AWenzel83/MCT-Labor_5529/README.md

# MCT-Labor_5529
Laboraufbau mit MSP-EXP430f5529-LP
