AWenzel83/MCT-Labor_5529/TODO.txt

-Battery-Protection einfuegen oder Halter für Akkus mit Schutzschaltung
