AWenzel83/MCT-Labor_5529/release/MCT_Labor_5529.pdf

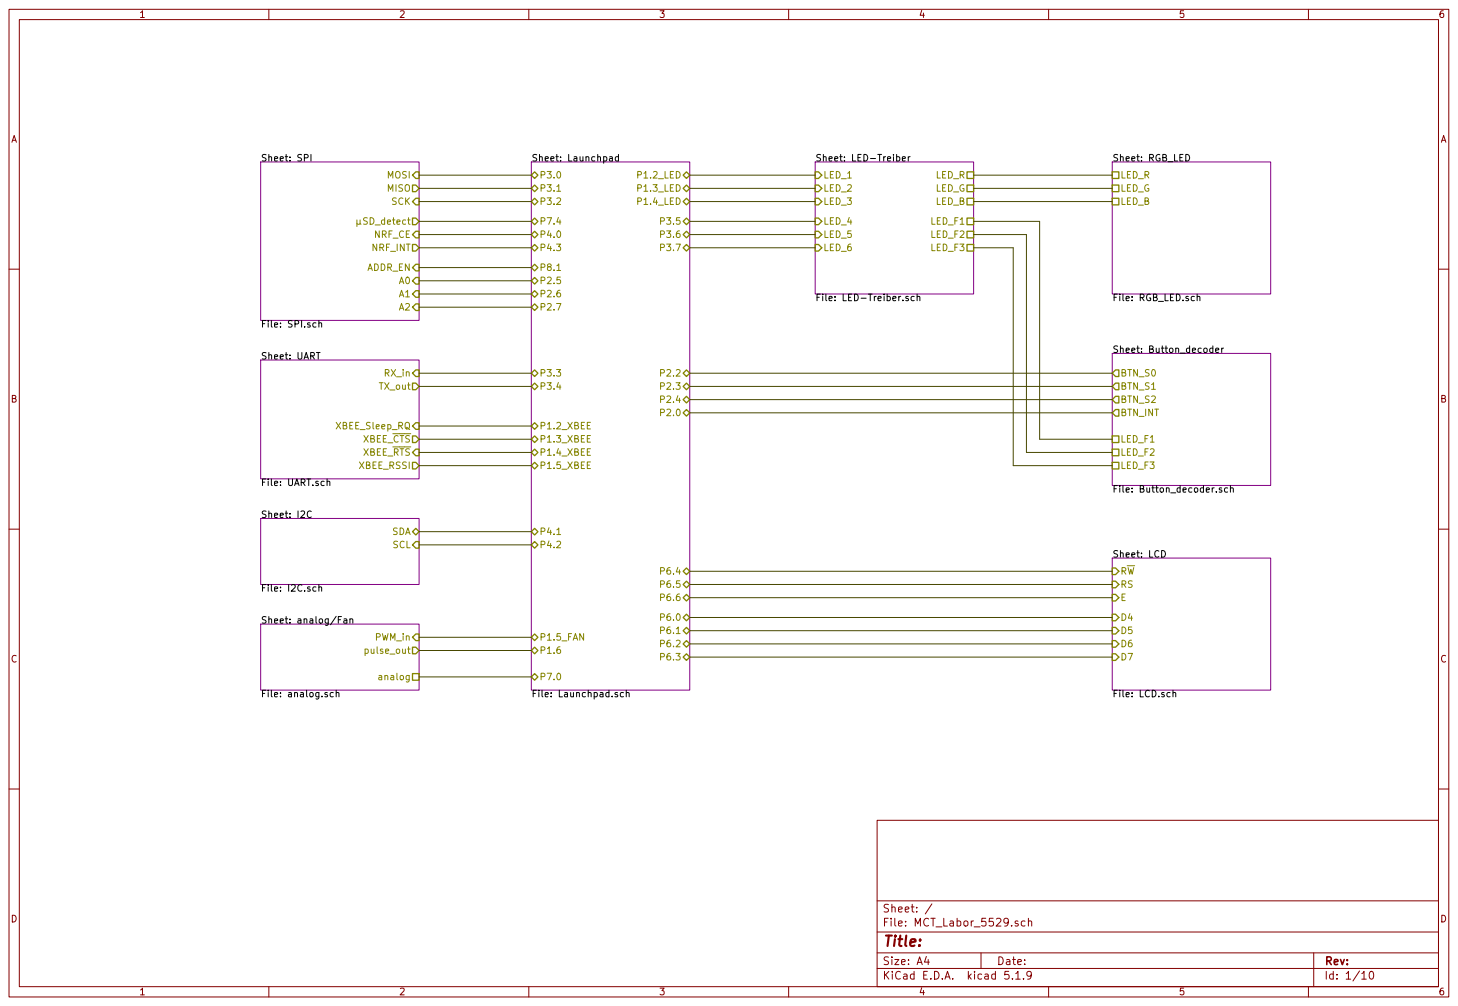
[picture p1: page 1]

File: LCD.sch D4 D5 D6 D7 RSRW

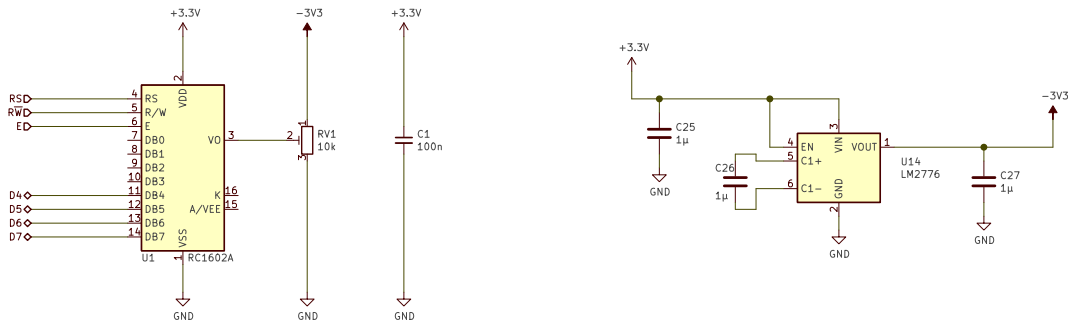
[picture p2: page 2]

Id: 2/10 Title: File: LCD.sch Sheet: /LCD/

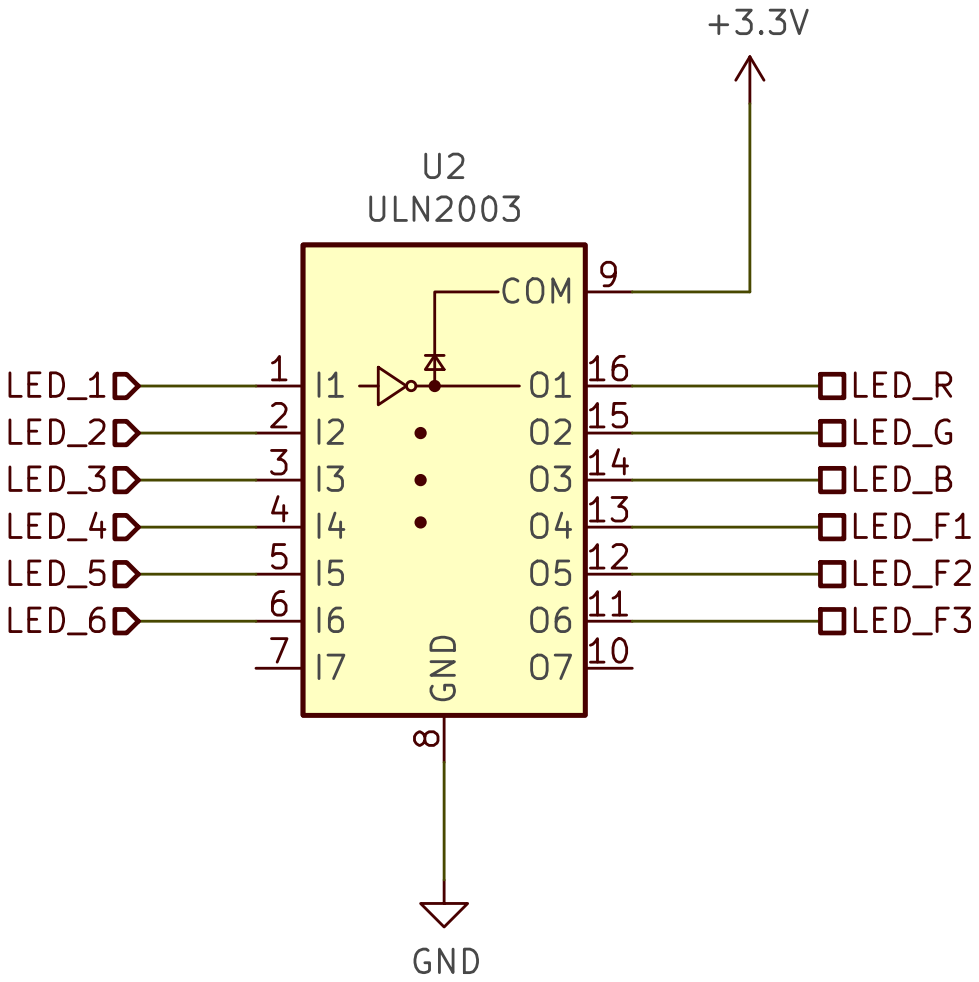
[picture p3: page 3]

Id: 3/10 Title: File: LED-Treiber.sch Sheet: /LED-Treiber/ GND

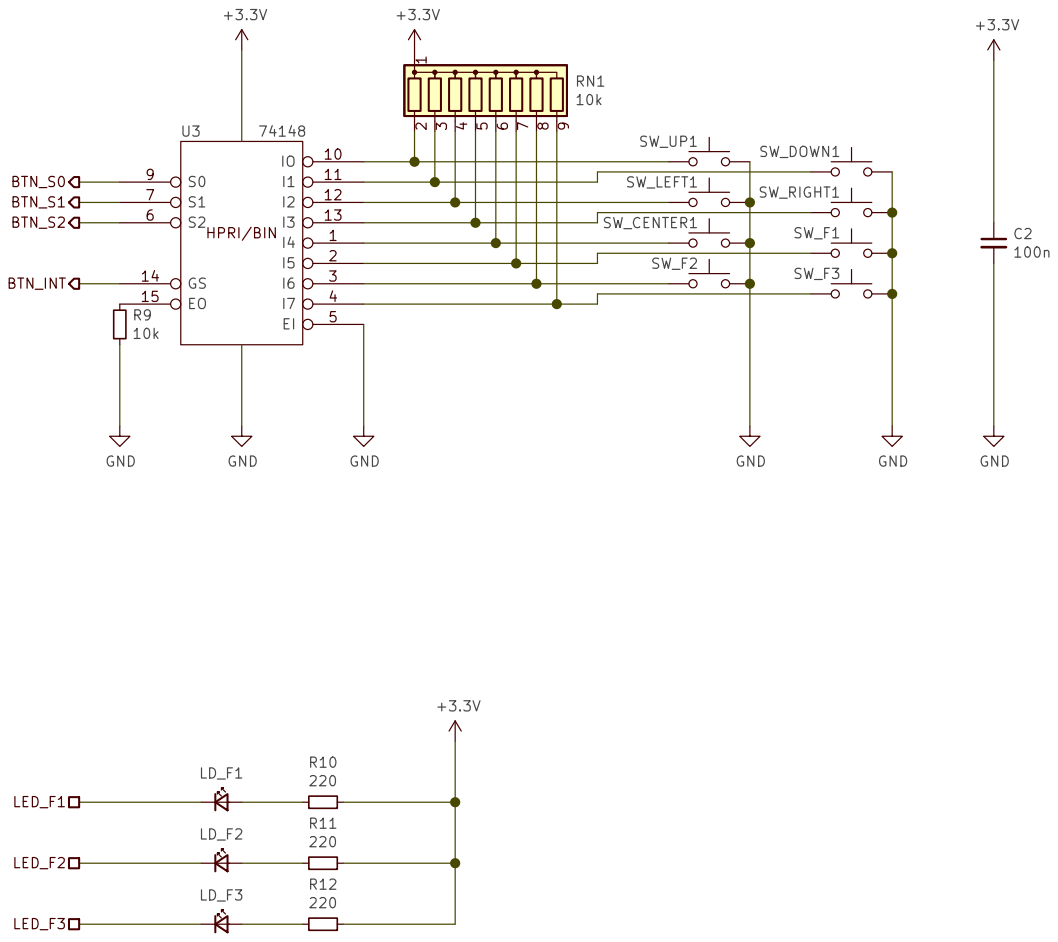
[picture p4: page 4]

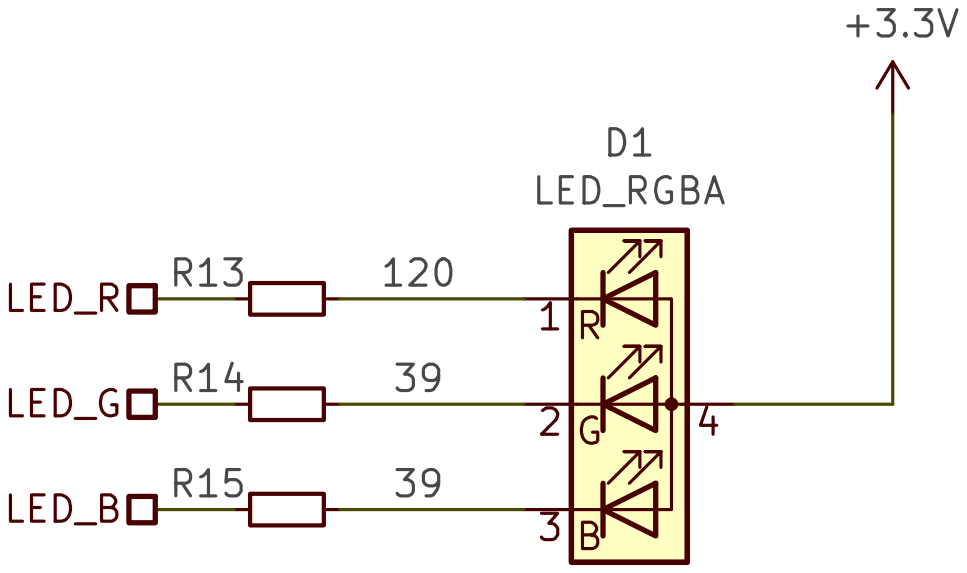
[picture p5: page 5]

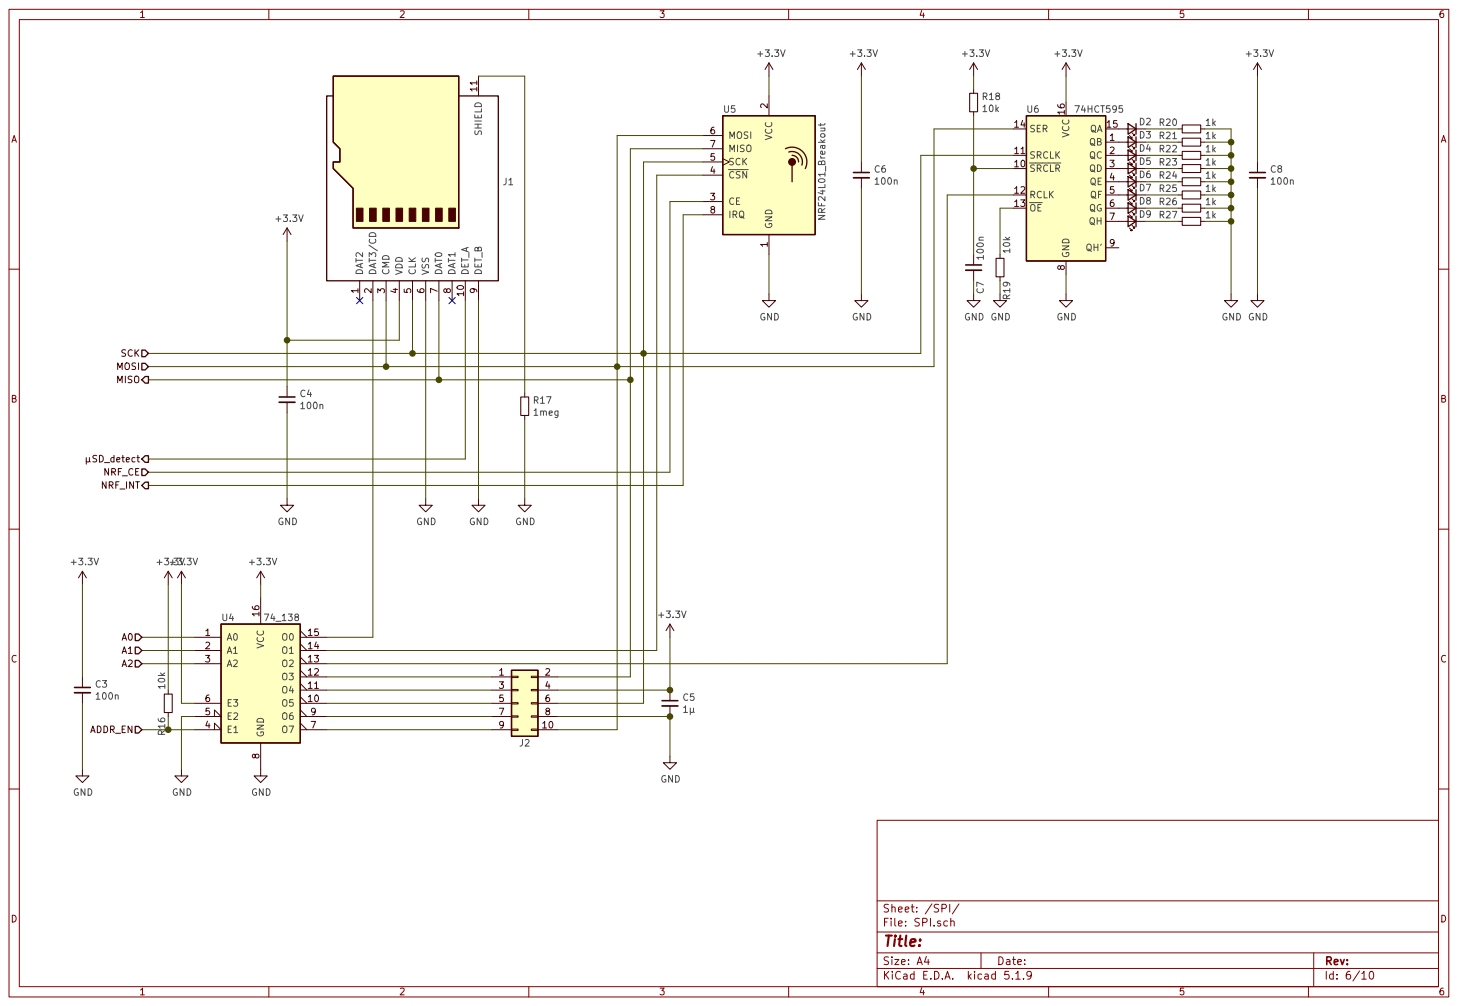
[picture p6: page 6]

2 CE 3 CSN 4 SCK 5 MOSI 6 MISO 7

Id: 6/10 Title: File: SPI.sch Sheet: /SPI/ DAT2

9 | 10

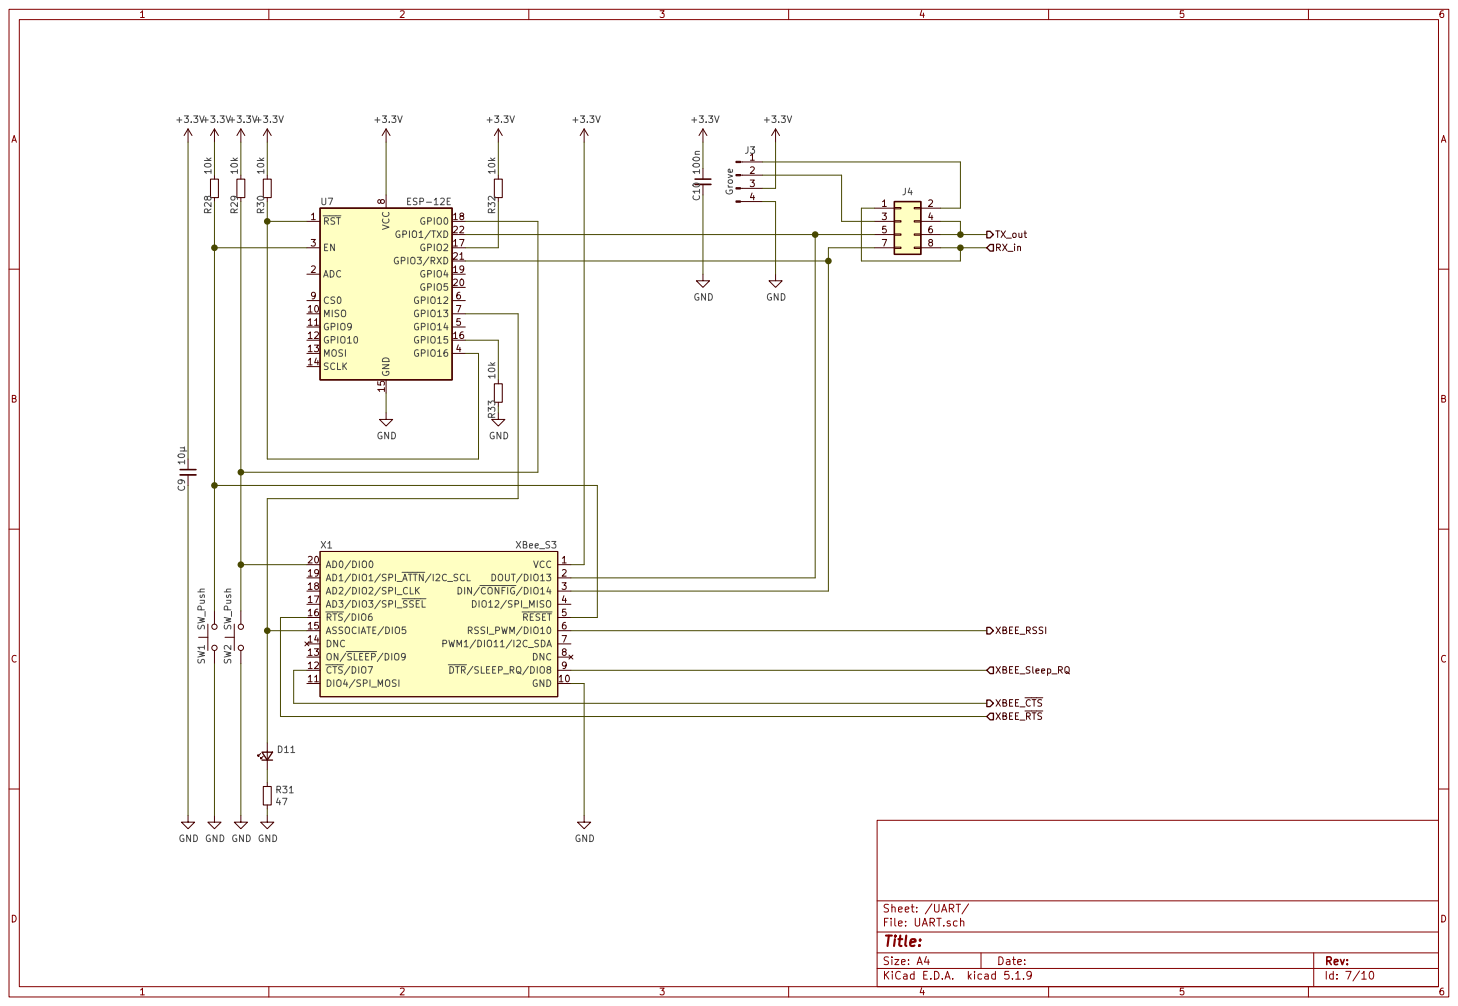
[picture p7: page 7]

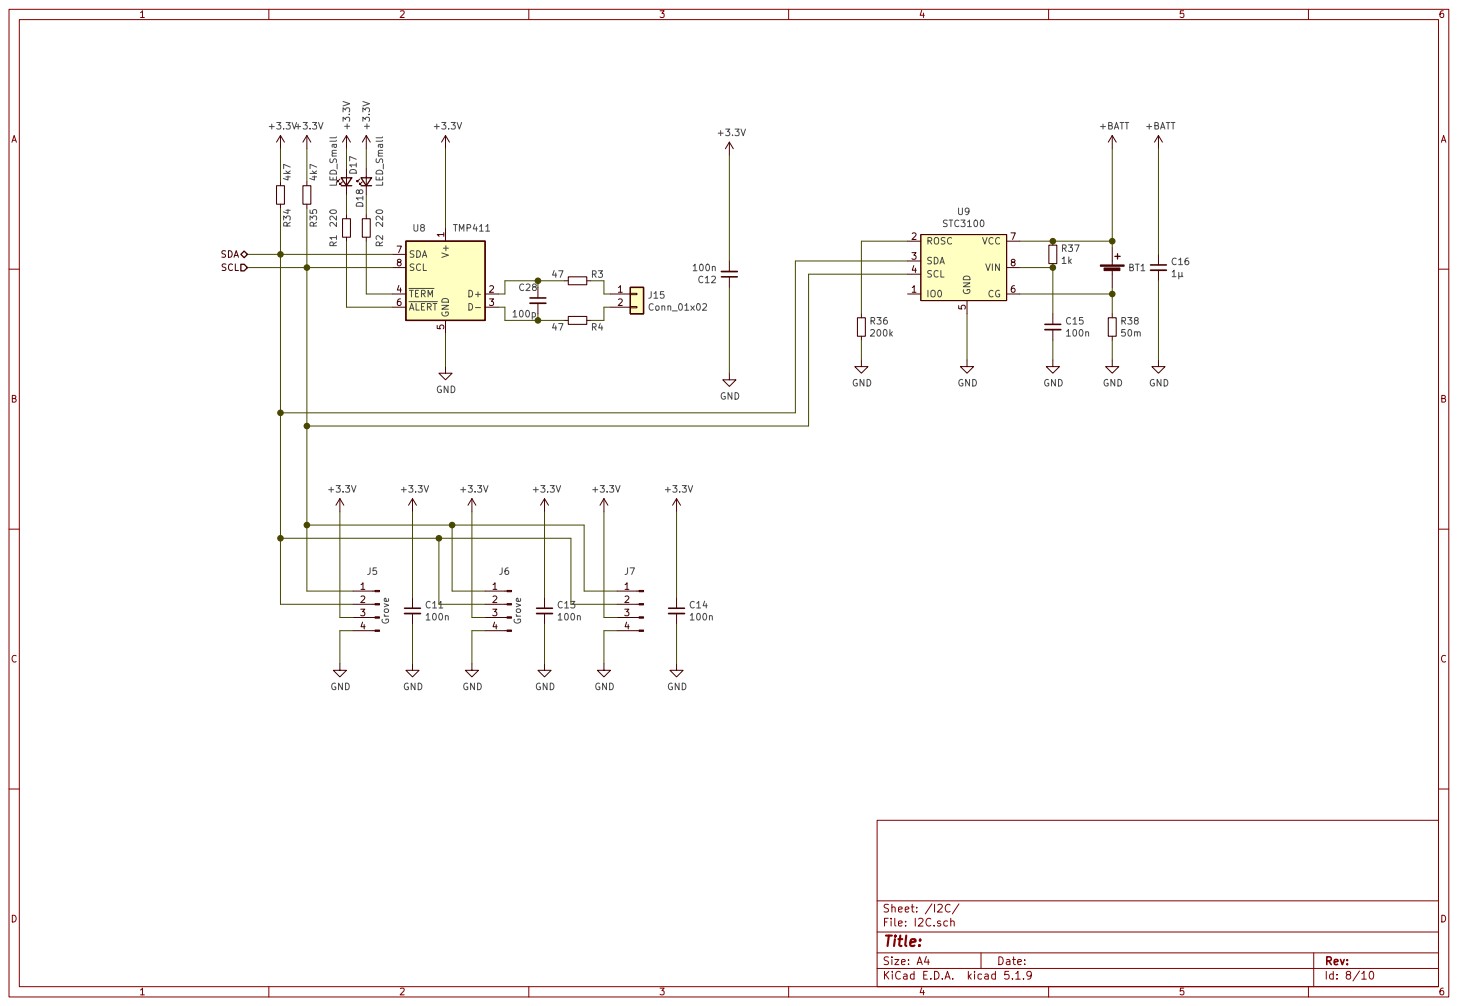
[picture p8: page 8]

5 ALERT 6 SDA 7 SCL 8 U8 TMP411 +3.3V GND

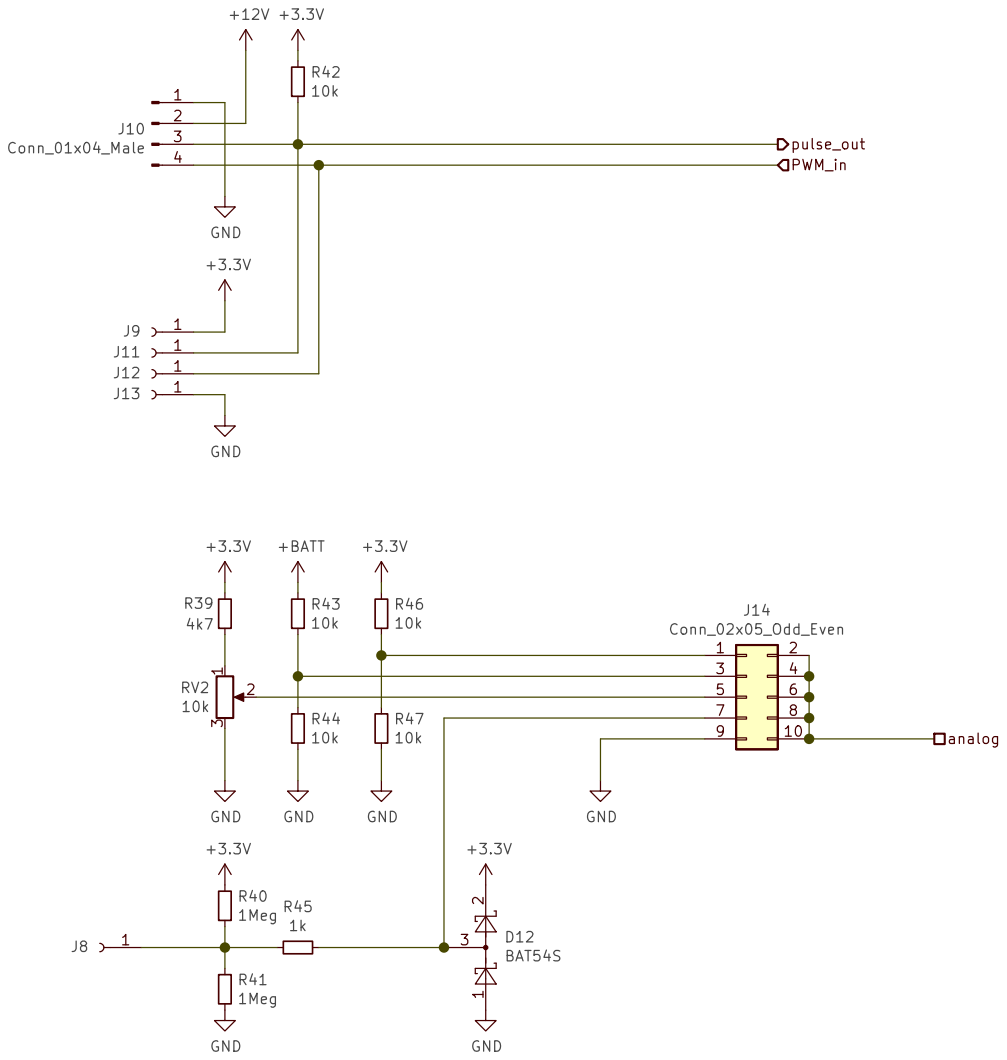
[picture p9: page 9]

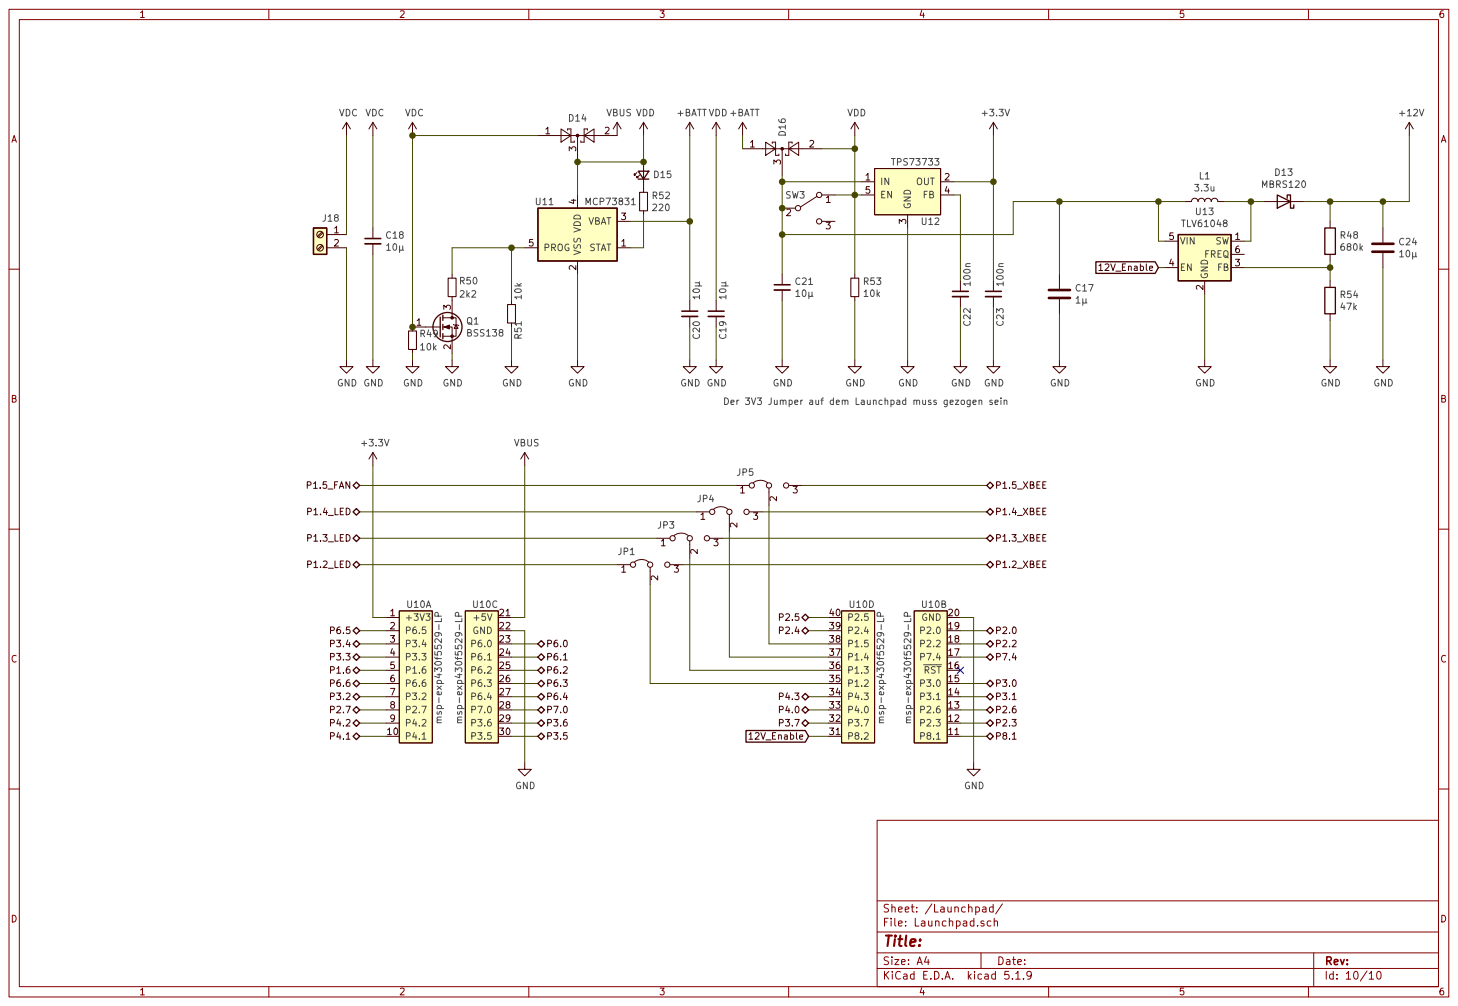
[picture p10: page 10]

2 FB 3 EN 4 VIN 5 FREQ 6 U13 TLV61048 +12V GND GND GND GND

3 FB 4 EN 5 U12 TPS73733 R51 10k GND GND

12V_Enable Der 3V3 Jumper auf dem Launchpad muss gezogen sein
