AWenzel83/MCT-Labor_5529/MCT_Labor_5529.kicad_pcb

## KiCad design MCT_Labor_5529.kicad_pcb (2021-04-28)

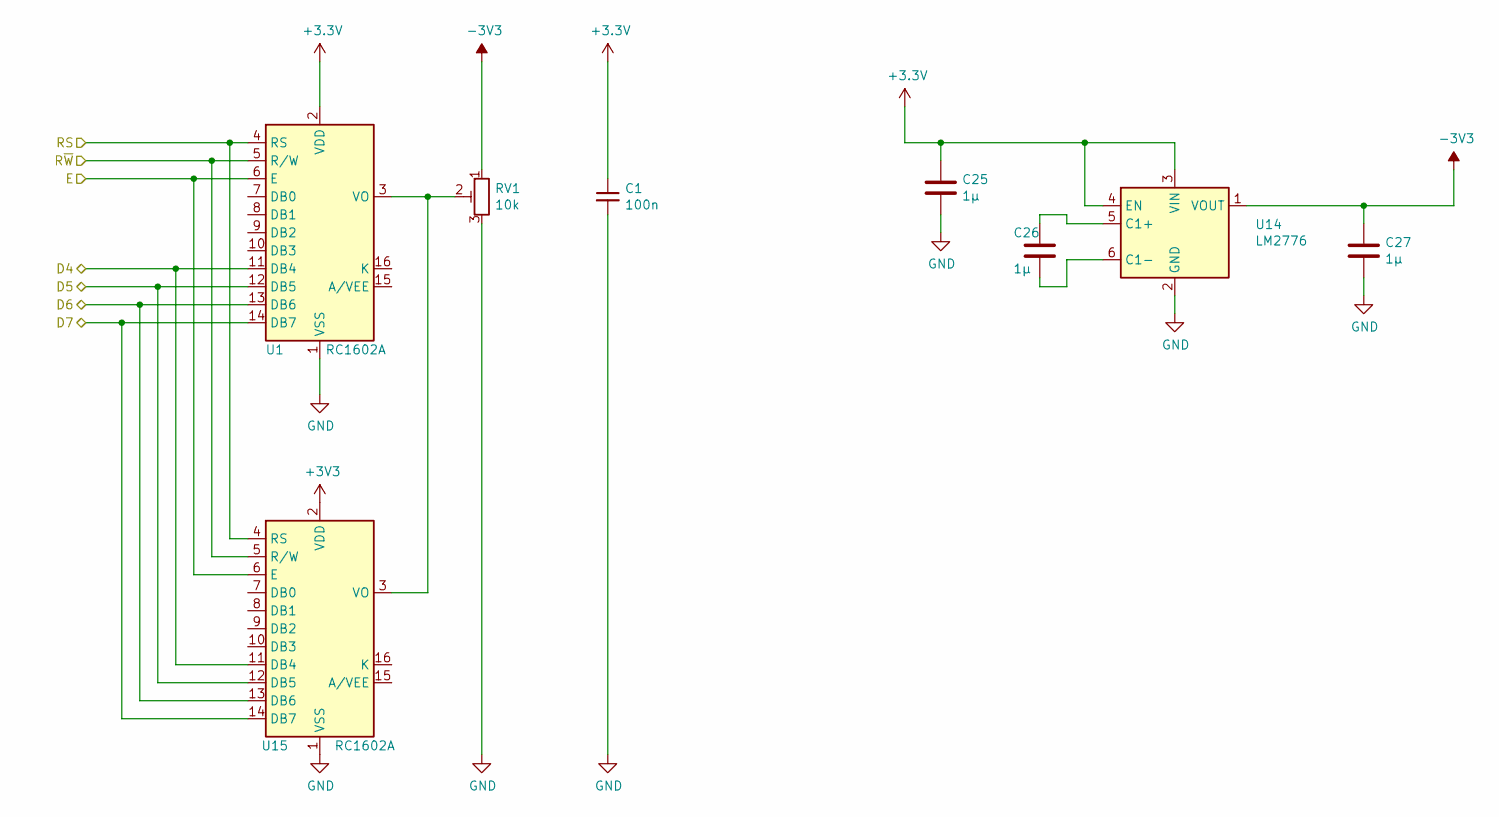
[picture p11: schematic LCD.sch]

Parts:
C1: 100n; C_0603_1608Metric_Pad1.05x0.95mm_HandSolder
C25, C26, C27: 1µ; C_0603_1608Metric_Pad1.05x0.95mm_HandSolder
RV1: 10k; Potentiometer_Bourns_3296P_Horizontal
U1: RC1602A; WC1602A
U14: LM2776; SOT-23-6
U15: RC1602A

Connections:
-3V3: C27.1, RV1.1, U14.1 (VOUT)
/LCD/D4: U1.11 (DB4), U15.11 (DB4); also elsewhere on the board
/LCD/D5: U1.12 (DB5), U15.12 (DB5); also elsewhere on the board
/LCD/D6: U1.13 (DB6), U15.13 (DB6); also elsewhere on the board
/LCD/D7: U1.14 (DB7), U15.14 (DB7); also elsewhere on the board
/LCD/E: U1.6 (E), U15.6 (E); also elsewhere on the board
/Launchpad/P6.4: U1.5 (R/W), U15.5 (R/W); also elsewhere on the board
/Launchpad/P6.5: U1.4 (RS), U15.4 (RS); also elsewhere on the board
GND: C1.2, C25.2, C27.2, RV1.3, U1.1 (VSS), U14.2 (GND), U15.1 (VSS); also elsewhere on the board
unnamed: C26.1, U14.5 (C1+)
unnamed: C26.2, U14.6 (C1-)
unnamed: RV1.2, U1.3 (VO), U15.3 (VO)

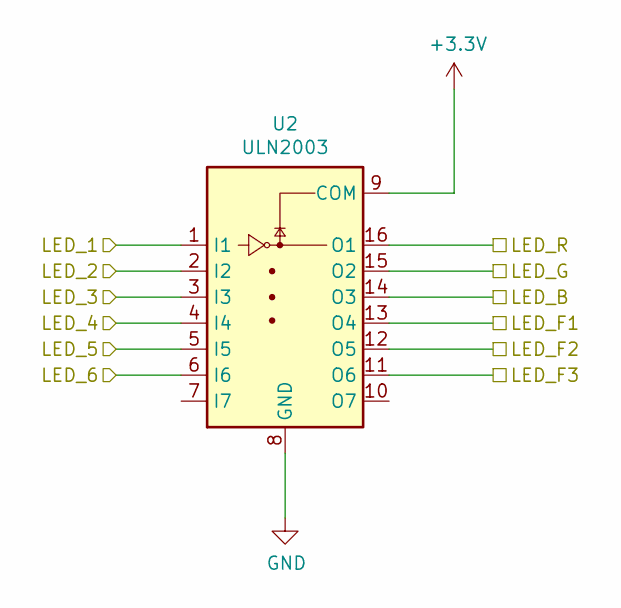
[picture p12: schematic LED-Treiber.sch]

Parts:
U2: ULN2003; SOIC-16_3.9x9.9mm_P1.27mm

Connections:
/Button_decoder/LED_F1: U2.13 (O4); also elsewhere on the board
/Button_decoder/LED_F2: U2.12 (O5); also elsewhere on the board
/Button_decoder/LED_F3: U2.11 (O6); also elsewhere on the board
/LED-Treiber/LED_1: U2.1 (I1); also elsewhere on the board
/LED-Treiber/LED_2: U2.2 (I2); also elsewhere on the board
/LED-Treiber/LED_3: U2.3 (I3); also elsewhere on the board
/LED-Treiber/LED_4: U2.4 (I4); also elsewhere on the board
/LED-Treiber/LED_5: U2.5 (I5); also elsewhere on the board
/LED-Treiber/LED_6: U2.6 (I6); also elsewhere on the board
/LED-Treiber/LED_B: U2.14 (O3); also elsewhere on the board
/LED-Treiber/LED_G: U2.15 (O2); also elsewhere on the board
/LED-Treiber/LED_R: U2.16 (O1); also elsewhere on the board
GND: U2.8 (GND); also elsewhere on the board

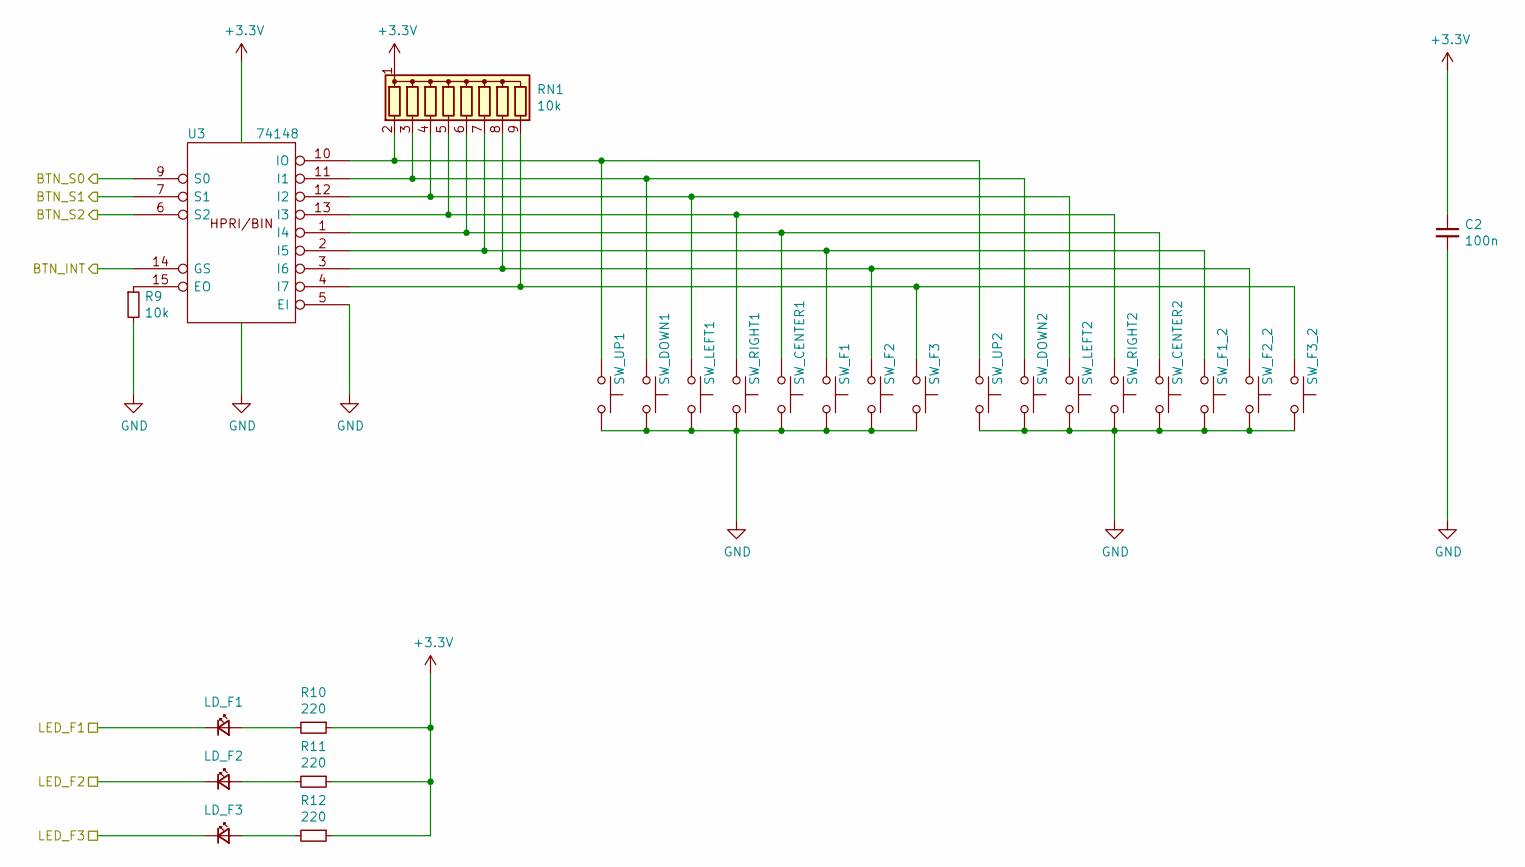
[picture p13: schematic Button_decoder.sch]

Parts:
C2: 100n; C_0603_1608Metric_Pad1.05x0.95mm_HandSolder
LD_F1, LD_F2, LD_F3: LED_Small; LED_D3.0mm
R9: 10k; R_0603_1608Metric_Pad1.05x0.95mm_HandSolder
R10, R11, R12: 220; R_0603_1608Metric_Pad1.05x0.95mm_HandSolder
RN1: 10k; R_Array_SIP9
SW_CENTER1: SW_MEC_5G; SW_MEC_5GSH9
SW_CENTER2: SW_MEC_5G; SW_SPST_Omron_B3FS-100xP
SW_DOWN1: SW_MEC_5G; SW_MEC_5GSH9
SW_DOWN2: SW_MEC_5G; SW_SPST_Omron_B3FS-100xP
SW_F1, SW_F2, SW_F3: SW_MEC_5G; SW_MEC_5GSH9
SW_F1_2: SW_MEC_5; SW_SPST_Omron_B3FS-100xP
SW_F2_2, SW_F3_2: SW_MEC_5G; SW_SPST_Omron_B3FS-100xP
SW_LEFT1: SW_MEC_5G; SW_MEC_5GSH9
SW_LEFT2: SW_MEC_5G; SW_SPST_Omron_B3FS-100xP
SW_RIGHT1: SW_MEC_5G; SW_MEC_5GSH9
SW_RIGHT2: SW_MEC_5G; SW_SPST_Omron_B3FS-100xP
SW_UP1: SW_MEC_5G; SW_MEC_5GSH9
SW_UP2: SW_MEC_5G; SW_SPST_Omron_B3FS-100xP
U3: 74148; SOIC-16_3.9x9.9mm_P1.27mm

Connections:
/Button_decoder/BTN_INT: U3.14 (GS); also elsewhere on the board
/Button_decoder/BTN_S0: U3.9 (S0); also elsewhere on the board
/Button_decoder/BTN_S1: U3.7 (S1); also elsewhere on the board
/Button_decoder/BTN_S2: U3.6 (S2); also elsewhere on the board
/Button_decoder/LED_F1: LD_F1.1 (K); also elsewhere on the board
/Button_decoder/LED_F2: LD_F2.1 (K); also elsewhere on the board
/Button_decoder/LED_F3: LD_F3.1 (K); also elsewhere on the board
GND: C2.2, R9.2, SW_CENTER1.3 (B), SW_CENTER1.4 (B), SW_CENTER2.3 (B), SW_CENTER2.4 (B), SW_DOWN1.3 (B), SW_DOWN1.4 (B), SW_DOWN2.3 (B), SW_DOWN2.4 (B), SW_F1.3 (B), SW_F1.4 (B), SW_F1_2.3 (B), SW_F1_2.4 (B), SW_F2.3 (B), SW_F2.4 (B), SW_F2_2.3 (B), SW_F2_2.4 (B), SW_F3.3 (B), SW_F3.4 (B), SW_F3_2.3 (B), SW_F3_2.4 (B), SW_LEFT1.3 (B), SW_LEFT1.4 (B), SW_LEFT2.3 (B), SW_LEFT2.4 (B), SW_RIGHT1.3 (B), SW_RIGHT1.4 (B), SW_RIGHT2.3 (B), SW_RIGHT2.4 (B), SW_UP1.3 (B), SW_UP1.4 (B), SW_UP2.3 (B), SW_UP2.4 (B), U3.5 (EI), U3.8 (GND); also elsewhere on the board
unnamed: LD_F1.2 (A), R10.2
unnamed: LD_F2.2 (A), R11.2
unnamed: LD_F3.2 (A), R12.2
unnamed: R9.1, U3.15 (EO)
unnamed: RN1.2 (R1), SW_UP1.1 (A), SW_UP1.2 (A), SW_UP2.1 (A), SW_UP2.2 (A), U3.10 (IO)
unnamed: RN1.3 (R2), SW_DOWN1.1 (A), SW_DOWN1.2 (A), SW_DOWN2.1 (A), SW_DOWN2.2 (A), U3.11 (I1)
unnamed: RN1.4 (R3), SW_LEFT1.1 (A), SW_LEFT1.2 (A), SW_LEFT2.1 (A), SW_LEFT2.2 (A), U3.12 (I2)
unnamed: RN1.5 (R4), SW_RIGHT1.1 (A), SW_RIGHT1.2 (A), SW_RIGHT2.1 (A), SW_RIGHT2.2 (A), U3.13 (I3)
unnamed: RN1.6 (R5), SW_CENTER1.1 (A), SW_CENTER1.2 (A), SW_CENTER2.1 (A), SW_CENTER2.2 (A), U3.1 (I4)
unnamed: RN1.7 (R6), SW_F1.1 (A), SW_F1.2 (A), SW_F1_2.1 (A), SW_F1_2.2 (A), U3.2 (I5)
unnamed: RN1.8 (R7), SW_F2.1 (A), SW_F2.2 (A), SW_F2_2.1 (A), SW_F2_2.2 (A), U3.3 (I6)
unnamed: RN1.9 (R8), SW_F3.1 (A), SW_F3.2 (A), SW_F3_2.1 (A), SW_F3_2.2 (A), U3.4 (I7)

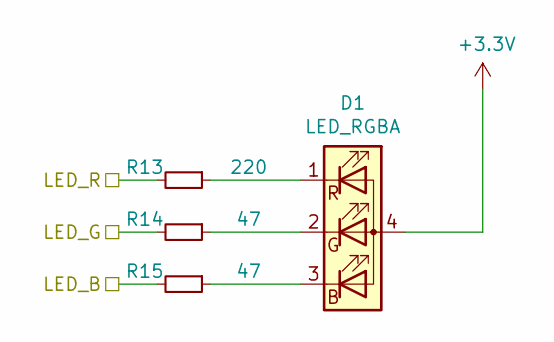
[picture p14: schematic RGB_LED.sch]

Parts:
D1: LED_RGBA; LED_Cree-PLCC4_3.2x2.8mm_CCW
R13: 220; R_0603_1608Metric_Pad1.05x0.95mm_HandSolder
R14, R15: 47; R_0603_1608Metric_Pad1.05x0.95mm_HandSolder

Connections:
/LED-Treiber/LED_B: R15.2; also elsewhere on the board
/LED-Treiber/LED_G: R14.2; also elsewhere on the board
/LED-Treiber/LED_R: R13.2; also elsewhere on the board
unnamed: D1.1 (RK), R13.1
unnamed: D1.2 (GK), R14.1
unnamed: D1.3 (BK), R15.1

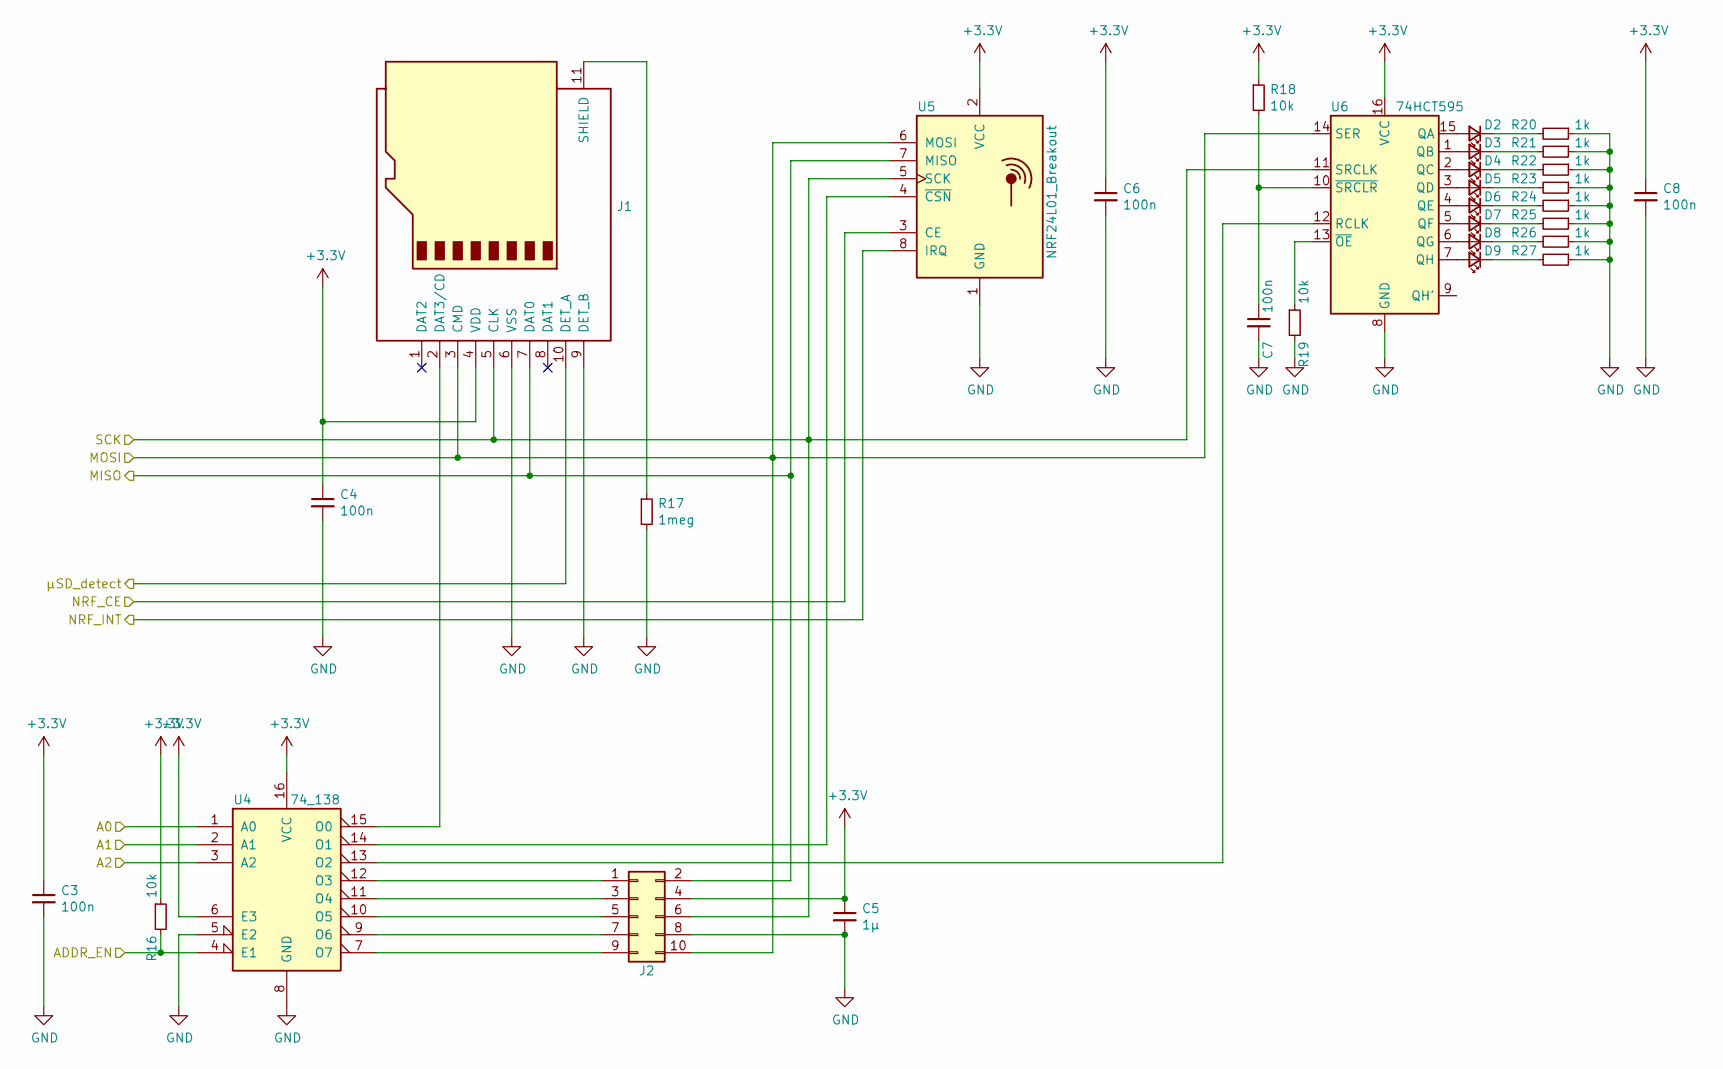
[picture p15: schematic SPI.sch]

Parts:
C3, C4, C6, C7, C8: 100n; C_0603_1608Metric_Pad1.05x0.95mm_HandSolder
C5: 1µ; C_0603_1608Metric_Pad1.05x0.95mm_HandSolder
D2, D3, D4, D5, D6, D7, D8, D9: LED_Small; LED_0603_1608Metric_Pad1.05x0.95mm_HandSolder
J1: Micro_SD_Card_Det; microSD_HC_Hirose_DM3D-SF
J2: Conn_02x05_Odd_Even; PinHeader_2x05_P2.54mm_Vertical
R16, R18, R19: 10k; R_0603_1608Metric_Pad1.05x0.95mm_HandSolder
R17: 1meg; R_0603_1608Metric_Pad1.05x0.95mm_HandSolder
R20, R21, R22, R23, R24, R25, R26, R27: 1k; R_0603_1608Metric_Pad1.05x0.95mm_HandSolder
U4: 74_138; SOIC-16_3.9x9.9mm_P1.27mm
U5: NRF24L01_Breakout; nRF24L01_Breakout
U6: 74HCT595; SOIC-16_3.9x9.9mm_P1.27mm

Connections:
/Launchpad/P3.2: J1.5 (CLK), J2.6, U5.5 (SCK), U6.11 (SRCLK); also elsewhere on the board
/Launchpad/P7.4: J1.10 (DET_A); also elsewhere on the board
/SPI/A0: U4.1 (A0); also elsewhere on the board
/SPI/A1: U4.2 (A1); also elsewhere on the board
/SPI/A2: U4.3 (A2); also elsewhere on the board
/SPI/ADDR_EN: R16.2, U4.4 (E1); also elsewhere on the board
/SPI/MISO: J1.7 (DAT0), J2.2, U5.7 (MISO); also elsewhere on the board
/SPI/MOSI: J1.3 (CMD), J2.10, U5.6 (MOSI), U6.14 (SER); also elsewhere on the board
/SPI/NRF_CE: U5.3 (CE); also elsewhere on the board
/SPI/NRF_INT: U5.8 (IRQ); also elsewhere on the board
GND: C3.2, C4.2, C5.2, C6.2, C7.2, C8.2, J1.6 (VSS), J1.9 (DET_B), J2.8, R17.2, R19.2, R20.1, R21.1, R22.1, R23.1, R24.1, R25.1, R26.1, R27.1, U4.5 (E2), U4.8 (GND), U5.1 (GND), U6.8 (GND); also elsewhere on the board
unnamed: C7.1, R18.2, U6.10 (~SRCLR)
unnamed: D2.1 (K), R20.2
unnamed: D2.2 (A), U6.15 (QA)
unnamed: D3.1 (K), R21.2
unnamed: D3.2 (A), U6.1 (QB)
unnamed: D4.1 (K), R22.2
unnamed: D4.2 (A), U6.2 (QC)
unnamed: D5.1 (K), R23.2
unnamed: D5.2 (A), U6.3 (QD)
unnamed: D6.1 (K), R24.2
unnamed: D6.2 (A), U6.4 (QE)
unnamed: D7.1 (K), R25.2
unnamed: D7.2 (A), U6.5 (QF)
unnamed: D8.1 (K), R26.2
unnamed: D8.2 (A), U6.6 (QG)
unnamed: D9.1 (K), R27.2
unnamed: D9.2 (A), U6.7 (QH)
unnamed: J1.2 (DAT3/CD), U4.15 (O0)
unnamed: J1.11 (SHIELD), R17.1
unnamed: J2.1, U4.12 (O3)
unnamed: J2.3, U4.11 (O4)
unnamed: J2.5, U4.10 (O5)
unnamed: J2.7, U4.9 (O6)
unnamed: J2.9, U4.7 (O7)
unnamed: R19.1, U6.13 (~OE)
unnamed: U4.13 (O2), U6.12 (RCLK)
unnamed: U4.14 (O1), U5.4 (~CSN)

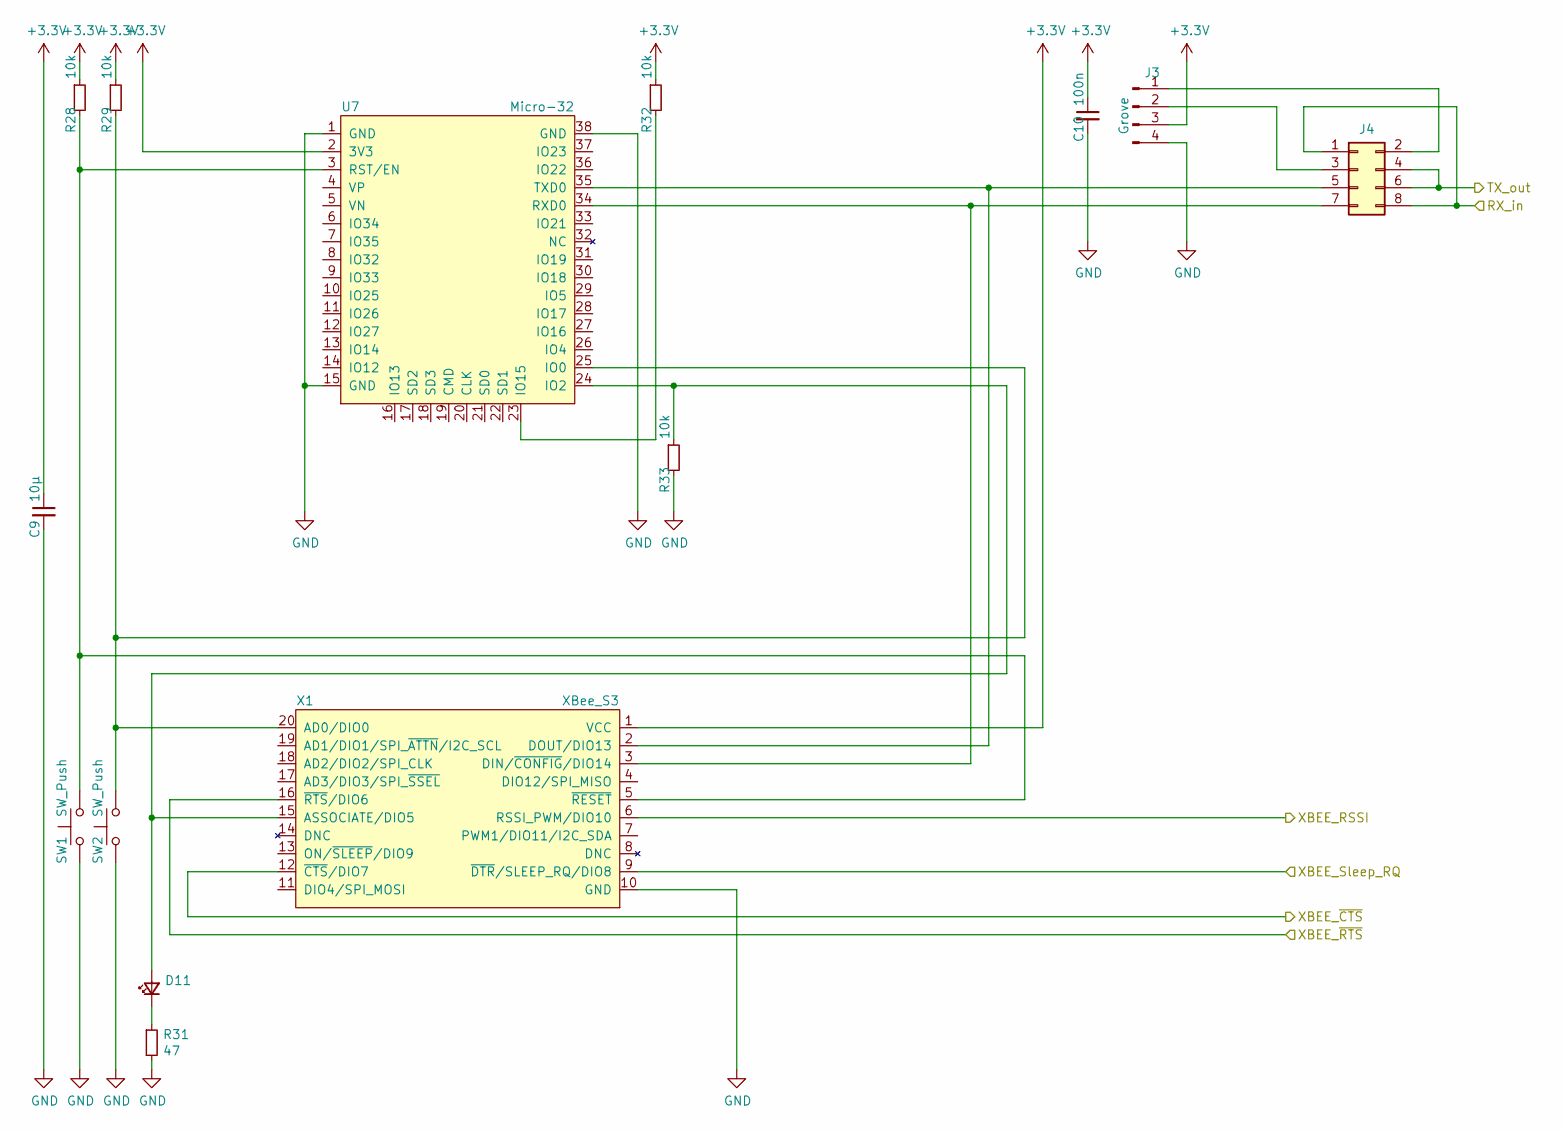
[picture p16: schematic UART.sch]

Parts:
C9: 10µ; C_1206_3216Metric_Pad1.42x1.75mm_HandSolder
C10: 100n; C_0603_1608Metric_Pad1.05x0.95mm_HandSolder
D11: LED_Small; LED_0603_1608Metric_Pad1.05x0.95mm_HandSolder
J3: Grove; NS-Tech_Grove_1x04_P2mm_Vertical
J4: Conn_02x04_Odd_Even; PinHeader_2x04_P2.54mm_Vertical
R28, R29, R32, R33: 10k; R_0603_1608Metric_Pad1.05x0.95mm_HandSolder
R31: 47; R_0603_1608Metric_Pad1.05x0.95mm_HandSolder
SW1, SW2: SW_Push; SW_Tactile_SPST_Angled_PTS645Vx39-2LFS
U7: Micro-32; micro32
X1: XBee_S3; XBEE_THT

Connections:
/Launchpad/P1.2_XBEE: X1.9 (~DTR~/SLEEP_RQ/DIO8); also elsewhere on the board
/Launchpad/P1.3_XBEE: X1.12 (~CTS~/DIO7); also elsewhere on the board
/Launchpad/P1.4_XBEE: X1.16 (~RTS~/DIO6); also elsewhere on the board
/Launchpad/P1.5_XBEE: X1.6 (RSSI_PWM/DIO10); also elsewhere on the board
/Launchpad/P3.3: J4.1, J4.8; also elsewhere on the board
/Launchpad/P3.4: J4.4, J4.6; also elsewhere on the board
GND: C9.2, C10.2, J3.4, R31.2, R33.2, SW1.1, SW2.1, U7.1 (GND), U7.15 (GND), U7.38 (GND), X1.10 (GND); also elsewhere on the board
unnamed: D11.1 (K), R31.1
unnamed: D11.2 (A), R33.1, U7.24 (IO2), X1.15 (ASSOCIATE/DIO5)
unnamed: J3.1, J4.2
unnamed: J3.2, J4.3
unnamed: J4.5, U7.35 (TXD0), X1.2 (DOUT/DIO13)
unnamed: J4.7, U7.34 (RXD0), X1.3 (DIN/~CONFIG~/DIO14)
unnamed: R28.2, SW1.2, U7.3 (RST/EN), X1.5 (~RESET)
unnamed: R29.2, SW2.2, U7.25 (IO0), X1.20 (AD0/DIO0)
unnamed: R32.2, U7.23 (IO15)

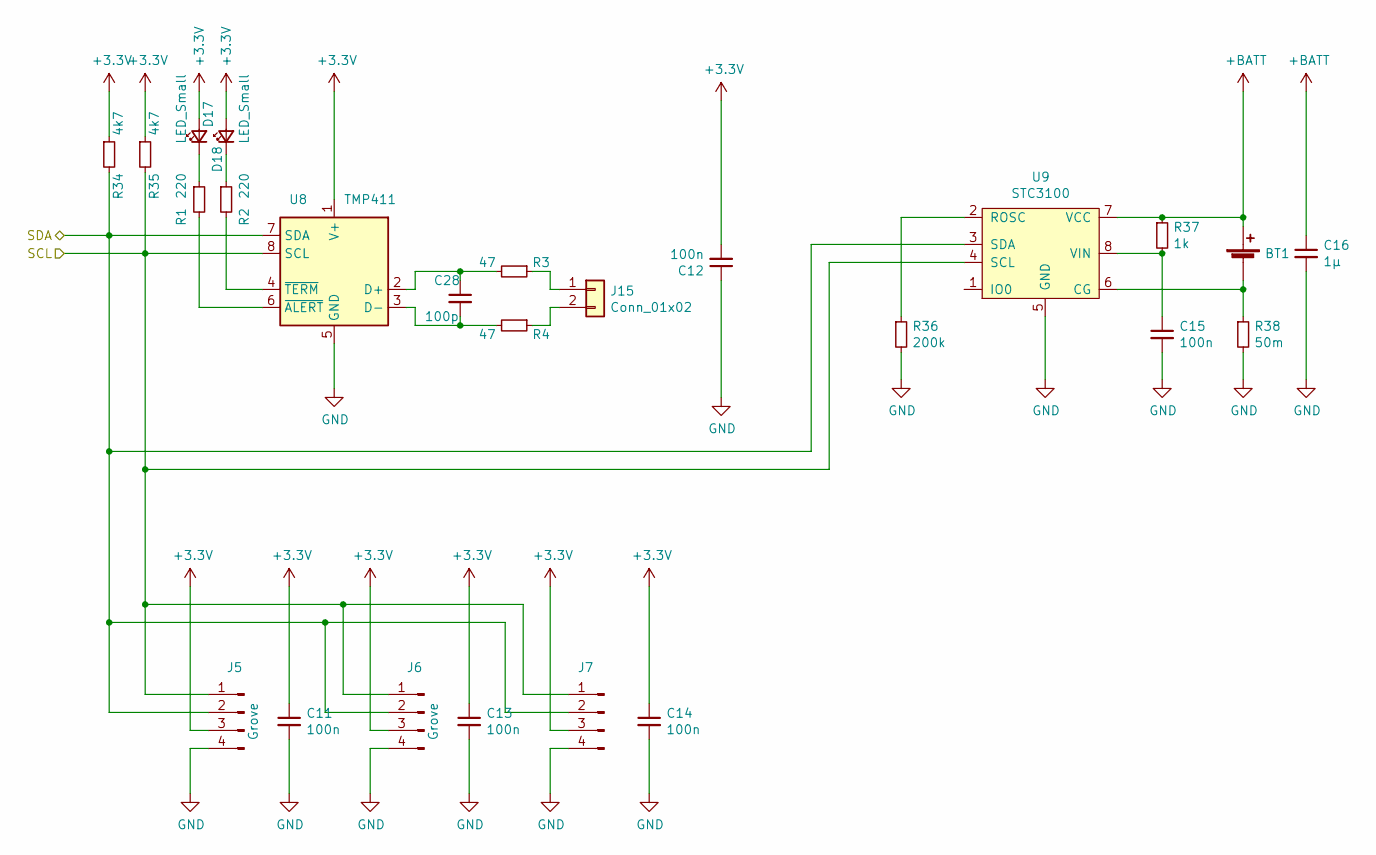
[picture p17: schematic I2C.sch]

Parts:
BT1: 18650_Cell; BatteryHolder_Keystone_1042_1x18650
C11, C12, C13, C14, C15: 100n; C_0603_1608Metric_Pad1.05x0.95mm_HandSolder
C16: 1µ; C_0603_1608Metric_Pad1.05x0.95mm_HandSolder
C28: 100p; C_0603_1608Metric_Pad1.05x0.95mm_HandSolder
D17, D18: LED_Small; LED_0603_1608Metric_Pad1.05x0.95mm_HandSolder
J5, J6: Grove; NS-Tech_Grove_1x04_P2mm_Vertical
J7: Conn_01x04_Male; PinHeader_1x04_P2.54mm_Vertical
J15: Conn_01x02; PinHeader_1x02_P2.54mm_Vertical
R1, R2: 220; R_0603_1608Metric_Pad1.05x0.95mm_HandSolder
R3, R4: 47; R_0603_1608Metric_Pad1.05x0.95mm_HandSolder
R34, R35: 4k7; R_0603_1608Metric_Pad1.05x0.95mm_HandSolder
R36: 200k; R_0603_1608Metric_Pad1.05x0.95mm_HandSolder
R37: 1k; R_0603_1608Metric_Pad1.05x0.95mm_HandSolder
R38: 50m; R_1206_3216Metric_Pad1.42x1.75mm_HandSolder
U8: TMP411; SO-8_3.9x4.9mm_P1.27mm
U9: STC3100; MSOP-8_3x3mm_P0.65mm

Connections:
+BATT: BT1.1 (+), C16.1, R37.1, U9.7 (VCC); also elsewhere on the board
/Launchpad/P4.1: J5.2, J6.2, J7.2, R34.2, U8.7 (SDA), U9.3 (SDA); also elsewhere on the board
/Launchpad/P4.2: J5.1, J6.1, J7.1, R35.2, U8.8 (SCL), U9.4 (SCL); also elsewhere on the board
GND: C11.2, C12.1, C13.2, C14.2, C15.2, C16.2, J5.4, J6.4, J7.4, R36.2, R38.2, U8.5 (GND), U9.5 (GND); also elsewhere on the board
unnamed: BT1.2 (-), R38.1, U9.6 (CG)
unnamed: C15.1, R37.2, U9.8 (VIN)
unnamed: C28.1, R3.2, U8.2 (D+)
unnamed: C28.2, R4.2, U8.3 (D-)
unnamed: D17.1 (K), R1.1
unnamed: D18.1 (K), R2.1
unnamed: J15.1, R3.1
unnamed: J15.2, R4.1
unnamed: R1.2, U8.6 (~ALERT)
unnamed: R2.2, U8.4 (~TERM)
unnamed: R36.1, U9.2 (ROSC)

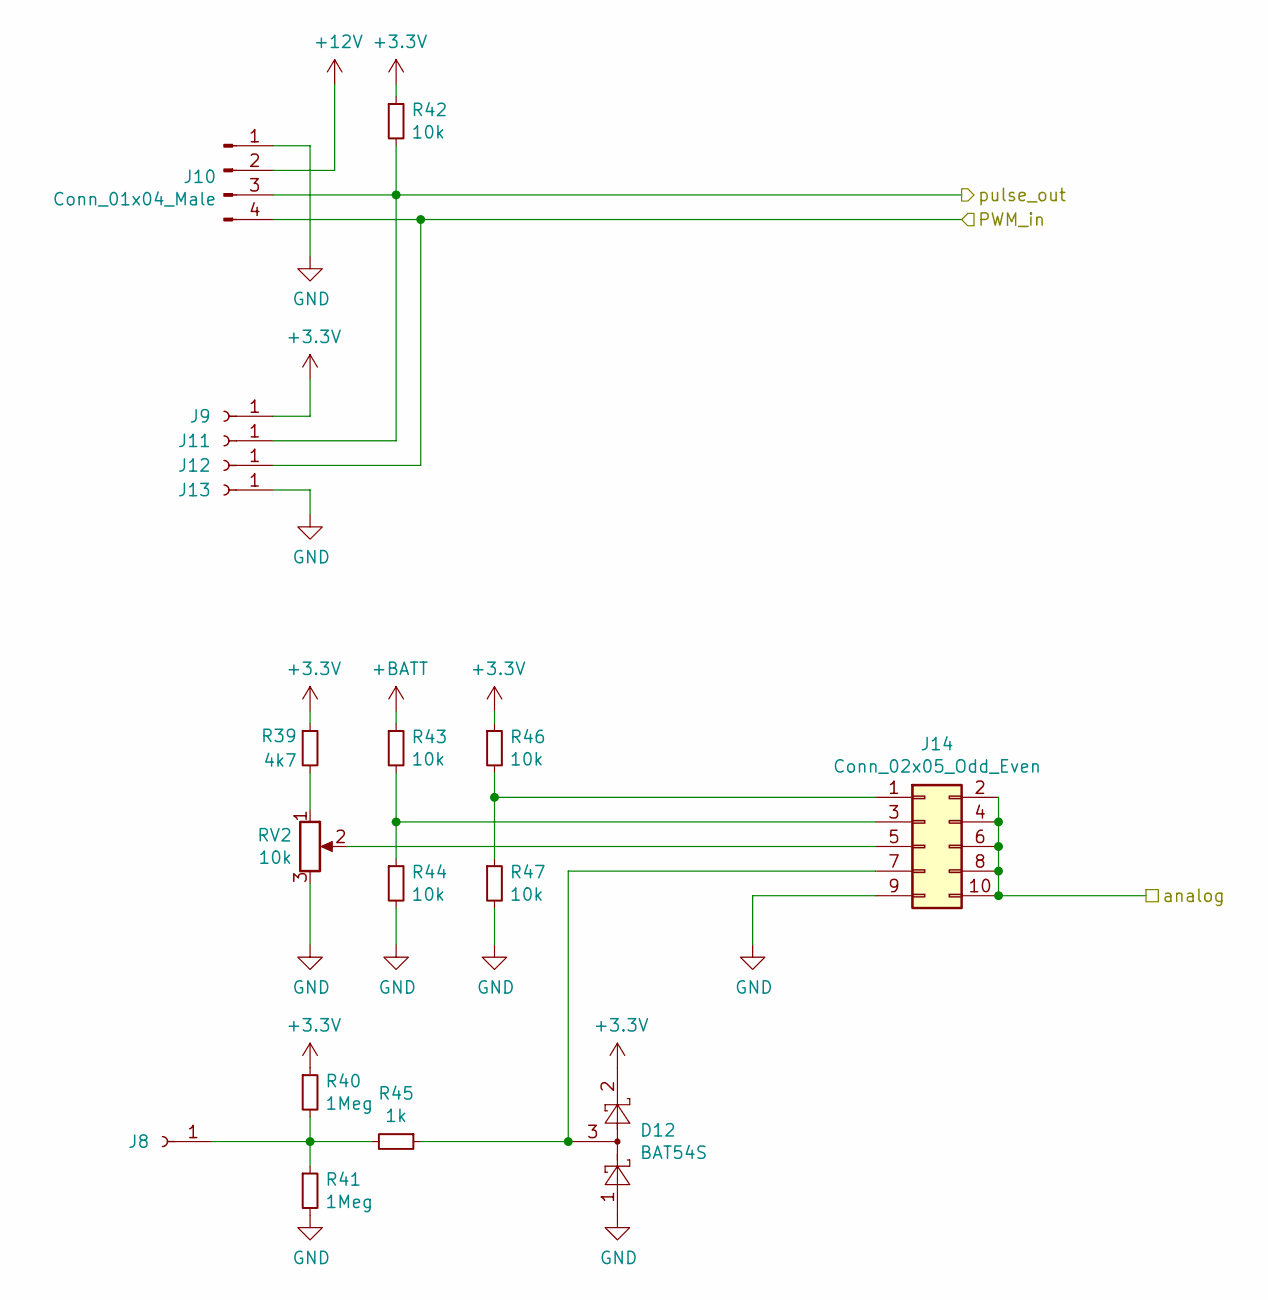
[picture p18: schematic analog.sch]

Parts:
D12: BAT54S; SOT-23
J8, J9, J11, J12, J13: Conn_01x01_Female; 2mm_Socket
J10: Conn_01x04_Male; Molex_KK-254_AE-6410-04A_1x04_P2.54mm_Vertical
J14: Conn_02x05_Odd_Even; PinHeader_2x05_P2.54mm_Vertical
R39: 4k7; R_0603_1608Metric_Pad1.05x0.95mm_HandSolder
R40, R41: 1Meg; R_0603_1608Metric_Pad1.05x0.95mm_HandSolder
R42, R43, R44, R46, R47: 10k; R_0603_1608Metric_Pad1.05x0.95mm_HandSolder
R45: 1k; R_0603_1608Metric_Pad1.05x0.95mm_HandSolder
RV2: 10k; Potentiometer_Alps_RK09K_Single_Vertical

Connections:
+12V: J10.2; also elsewhere on the board
+BATT: R43.1; also elsewhere on the board
/Launchpad/P1.5_FAN: J10.4, J12.1; also elsewhere on the board
/Launchpad/P1.6: J10.3, J11.1, R42.2; also elsewhere on the board
/Launchpad/P7.0: J14.2, J14.4, J14.6, J14.8, J14.10; also elsewhere on the board
GND: D12.1, J10.1, J13.1, J14.9, R41.2, R44.2, R47.2, RV2.3; also elsewhere on the board
unnamed: D12.3, J14.7, R45.1
unnamed: J8.1, R40.2, R41.1, R45.2
unnamed: J14.1, R46.2, R47.1
unnamed: J14.3, R43.2, R44.1
unnamed: J14.5, RV2.2
unnamed: R39.2, RV2.1

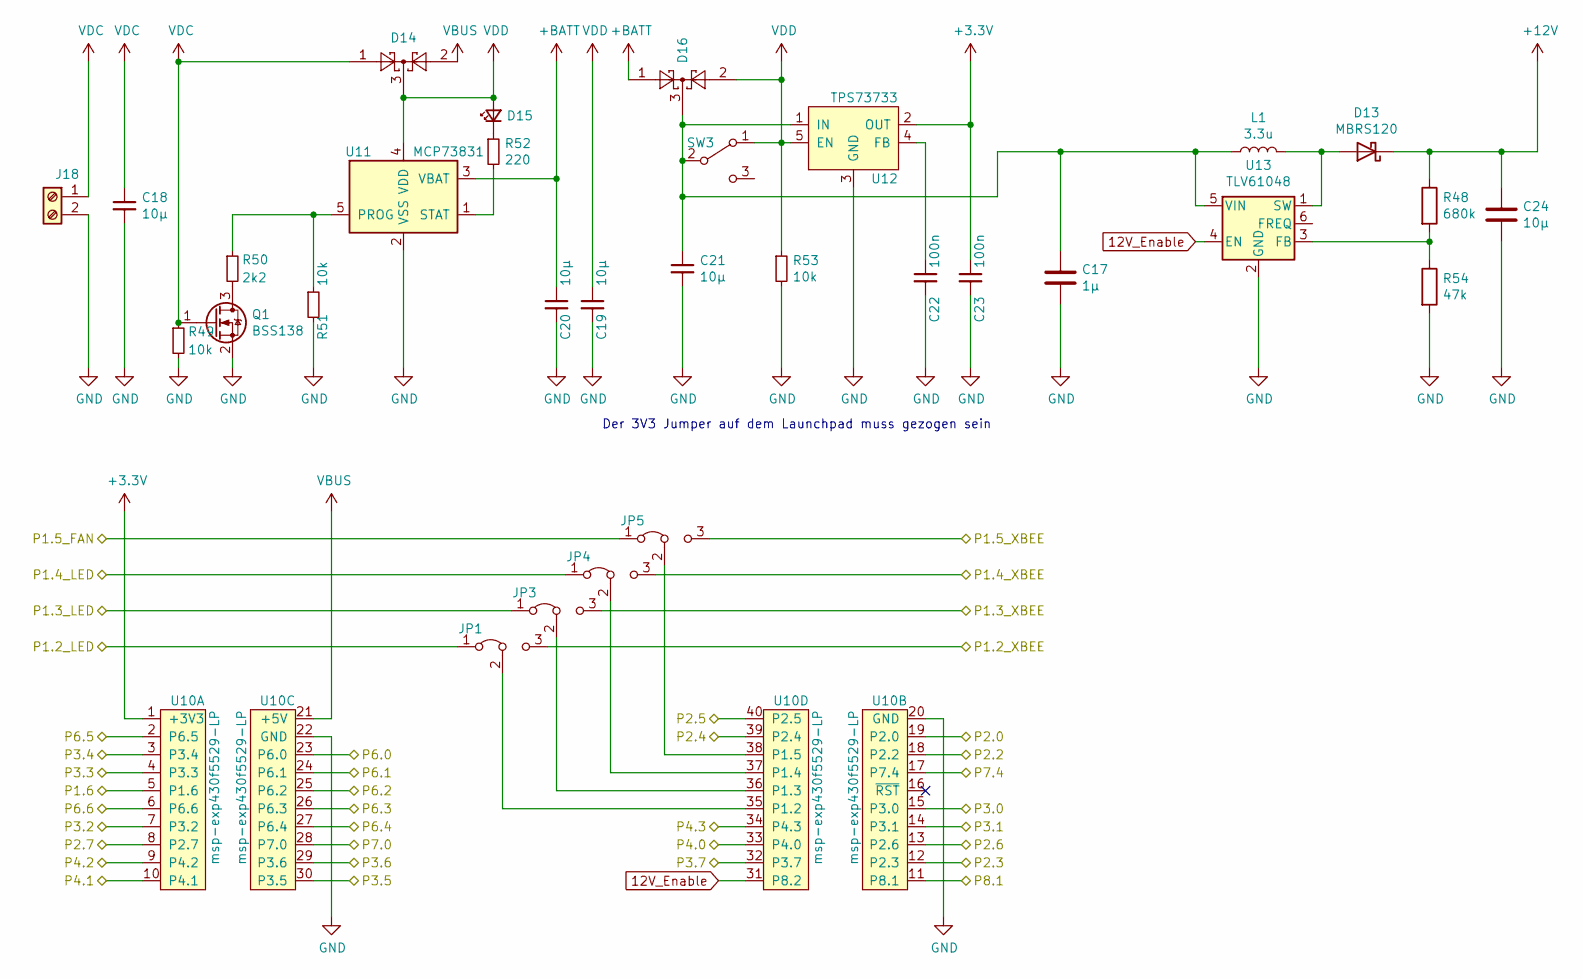
[picture p19: schematic Launchpad.sch]

Parts:
C17: 1µ; C_0603_1608Metric_Pad1.05x0.95mm_HandSolder
C18, C19, C20, C21, C24: 10µ; C_1206_3216Metric_Pad1.42x1.75mm_HandSolder
C22, C23: 100n; C_0603_1608Metric_Pad1.05x0.95mm_HandSolder
D13: MBRS120; D_SMB_Handsoldering
D14, D16: BAT54C; SOT-23
D15: LED_Small; LED_0603_1608Metric_Pad1.05x0.95mm_HandSolder
J18: Screw_Terminal_01x02; TerminalBlock_Phoenix_MKDS-3-2-5.08_1x02_P5.08mm_Horizontal
JP1, JP3, JP4, JP5: JP_3; PinHeader_1x03_P2.54mm_Vertical
L1: 3.3u; L_Coilcraft_XxL4040_handsolder
Q1: BSS138; SOT-23
R48: 680k; R_0603_1608Metric_Pad1.05x0.95mm_HandSolder
R49, R51, R53: 10k; R_0603_1608Metric_Pad1.05x0.95mm_HandSolder
R50: 2k2; R_0603_1608Metric_Pad1.05x0.95mm_HandSolder
R52: 220; R_0603_1608Metric_Pad1.05x0.95mm_HandSolder
R54: 47k; R_0603_1608Metric_Pad1.05x0.95mm_HandSolder
SW3: SW_SPDT; SS_13PLP
U10: msp-exp430f5529-LP; TI_Launchpad
U11: MCP73831; SOT-23-5
U12: TPS73733; SOT-223-6
U13: TLV61048; SOT-23-6

Connections:
12V_Enable: U10.31 (P8.2), U13.4 (EN)
+12V: C24.1, D13.1 (K), R48.1; also elsewhere on the board
+BATT: C20.1, D16.1, U11.3 (VBAT); also elsewhere on the board
/Button_decoder/BTN_INT: U10.19 (P2.0); also elsewhere on the board
/Button_decoder/BTN_S0: U10.18 (P2.2); also elsewhere on the board
/Button_decoder/BTN_S1: U10.12 (P2.3); also elsewhere on the board
/Button_decoder/BTN_S2: U10.39 (P2.4); also elsewhere on the board
/LCD/D4: U10.23 (P6.0); also elsewhere on the board
/LCD/D5: U10.24 (P6.1); also elsewhere on the board
/LCD/D6: U10.25 (P6.2); also elsewhere on the board
/LCD/D7: U10.26 (P6.3); also elsewhere on the board
/LCD/E: U10.6 (P6.6); also elsewhere on the board
/LED-Treiber/LED_1: JP1.1 (A); also elsewhere on the board
/LED-Treiber/LED_2: JP3.1 (A); also elsewhere on the board
/LED-Treiber/LED_3: JP4.1 (A); also elsewhere on the board
/LED-Treiber/LED_4: U10.30 (P3.5); also elsewhere on the board
/LED-Treiber/LED_5: U10.29 (P3.6); also elsewhere on the board
/LED-Treiber/LED_6: U10.32 (P3.7); also elsewhere on the board
/Launchpad/P1.2_XBEE: JP1.3 (B); also elsewhere on the board
/Launchpad/P1.3_XBEE: JP3.3 (B); also elsewhere on the board
/Launchpad/P1.4_XBEE: JP4.3 (B); also elsewhere on the board
/Launchpad/P1.5_FAN: JP5.1 (A); also elsewhere on the board
/Launchpad/P1.5_XBEE: JP5.3 (B); also elsewhere on the board
/Launchpad/P1.6: U10.5 (P1.6); also elsewhere on the board
/Launchpad/P3.2: U10.7 (P3.2); also elsewhere on the board
/Launchpad/P3.3: U10.4 (P3.3); also elsewhere on the board
/Launchpad/P3.4: U10.3 (P3.4); also elsewhere on the board
/Launchpad/P4.1: U10.10 (P4.1); also elsewhere on the board
/Launchpad/P4.2: U10.9 (P4.2); also elsewhere on the board
/Launchpad/P6.4: U10.27 (P6.4); also elsewhere on the board
/Launchpad/P6.5: U10.2 (P6.5); also elsewhere on the board
/Launchpad/P7.0: U10.28 (P7.0); also elsewhere on the board
/Launchpad/P7.4: U10.17 (P7.4); also elsewhere on the board
/SPI/A0: U10.40 (P2.5); also elsewhere on the board
/SPI/A1: U10.13 (P2.6); also elsewhere on the board
/SPI/A2: U10.8 (P2.7); also elsewhere on the board
/SPI/ADDR_EN: U10.11 (P8.1); also elsewhere on the board
/SPI/MISO: U10.14 (P3.1); also elsewhere on the board
/SPI/MOSI: U10.15 (P3.0); also elsewhere on the board
/SPI/NRF_CE: U10.33 (P4.0); also elsewhere on the board
/SPI/NRF_INT: U10.34 (P4.3); also elsewhere on the board
GND: C17.2, C18.2, C19.2, C20.2, C21.2, C22.2, C23.2, C24.2, J18.2, Q1.2 (S), R49.2, R51.2, R53.2, R54.2, U10.20 (GND), U10.22 (GND), U11.2 (VSS), U12.3 (GND), U12.6 (GND), U13.2 (GND); also elsewhere on the board
unnamed: C17.1, C21.1, D16.3, L1.1, SW3.2 (B), U12.1 (IN), U13.5 (VIN)
unnamed: C22.1, U12.4 (FB)
unnamed: D13.2 (A), L1.2, U13.1 (SW)
unnamed: D15.1 (K), R52.1
unnamed: JP1.2 (C), U10.35 (P1.2)
unnamed: JP3.2 (C), U10.36 (P1.3)
unnamed: JP4.2 (C), U10.37 (P1.4)
unnamed: JP5.2 (C), U10.38 (P1.5)
unnamed: Q1.3 (D), R50.2
unnamed: R48.2, R54.1, U13.3 (FB)
unnamed: R50.1, R51.1, U11.5 (PROG)
unnamed: R52.2, U11.1 (STAT)
VBUS: D14.2, U10.21 (+5V)
VDC: C18.1, D14.1, J18.1, Q1.1 (G), R49.1
VDD: C19.1, D14.3, D15.2 (A), D16.2, R53.1, SW3.1 (A), U11.4 (VDD), U12.5 (EN)

Notes on the sheet:
Der 3V3 Jumper auf dem Launchpad muss gezogen sein

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
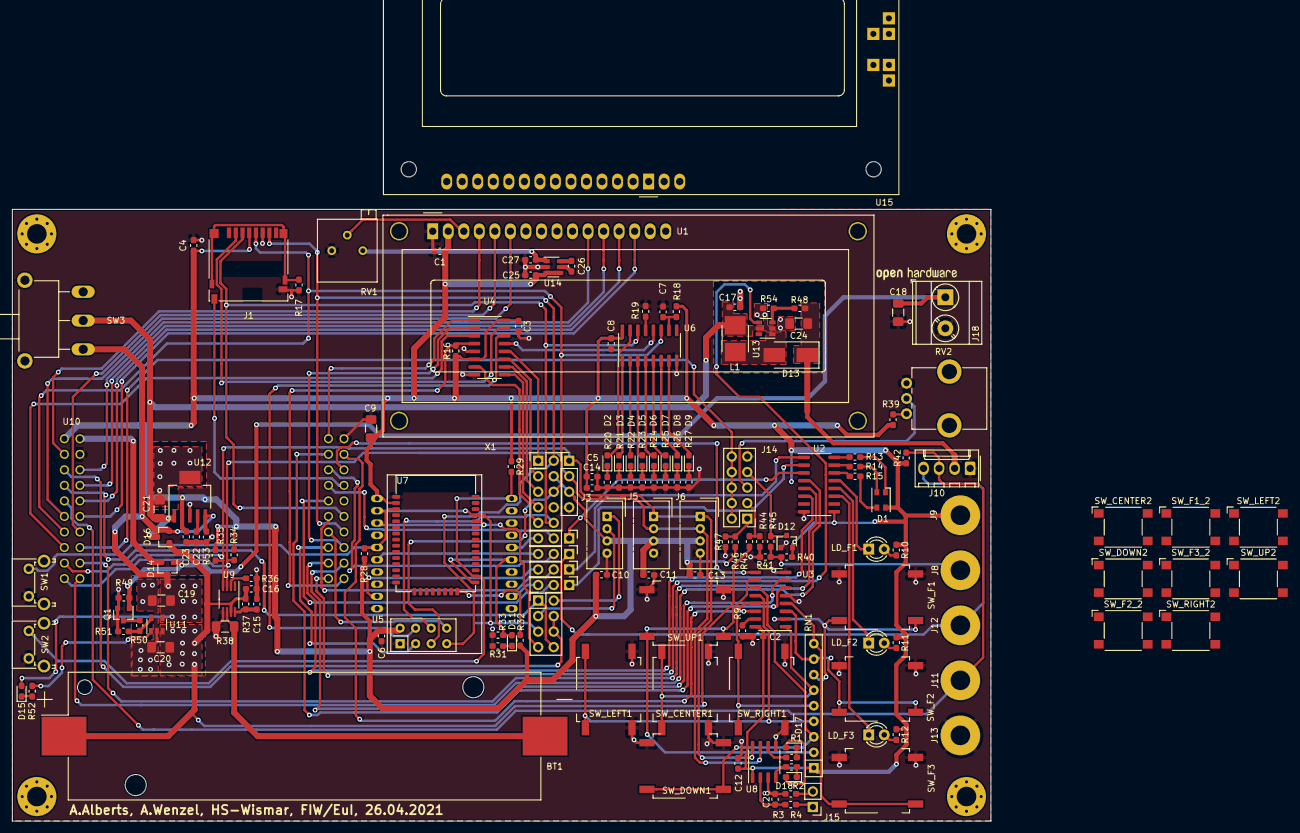
[picture p20: board MCT_Labor_5529.kicad_pcb from above]

Board: 2 copper layers, 160.0 x 100.0 mm, 159 parts (0 on the bottom side), 136 nets.

Other parts of the board:
e: MountingHole_3.2mm_M3_Pad_Via
