AWenzel83/MCT-Labor_5529/(commit log)

2020-06-16 Projekt angelegt
    Projekt angelegt
    [MCT_Labor_5529.kicad_pcb, MCT_Labor_5529.sch]
2020-06-16 LCD-File hinzugefügt
    [LCD.sch, MCT_Labor_5529.sch]
2020-06-19 Erster Entwurf fürs Pinout
    [pinout.ods]
2020-06-19 Footprintbibliothek eingefügt
2020-06-19 Schaltplan angefangen
    [Button_decoder.sch, LED-Treiber.sch, Launchpad.sch, MCT_Labor_5529.sch, RGB_LED.sch, pinout.ods]
2020-06-25 Blockschaltbild komplett v1
    [Button_decoder.sch, I2C.sch, LCD.sch, LED-Treiber.sch, Launchpad.sch, MCT_Labor_5529.sch, RGB_LED.sch, SPI.sch]
2020-07-01 Erste fertige Version
    [I2C.sch, LCD.sch, Launchpad.sch, MCT_Labor_5529.sch, SPI.sch, UART.sch, analog.sch, pinout.ods]
2020-07-03 Externe Spannungsversorgung
    [I2C.sch, UART.sch]
2020-07-03 da war noch nicht alles gespeichert
    [Launchpad.sch]
2020-07-07 Bauteile grob platziert
    [Button_decoder.sch, I2C.sch, LCD.sch, LED-Treiber.sch, Launchpad.sch, RGB_LED.sch, SPI.sch, UART.sch]
2020-07-13 Alle Bauteile platziert
    Alle Bauteile sind grob plaziert.
    Einige Bauteile sollten noch umplaziert werden (u. a. die Jumper links neben Groov-Con, RGB-LED,).
    [Button_decoder.sch, I2C.sch, LCD.sch, LED-Treiber.sch, Launchpad.sch, MCT_Labor_5529.kicad_pcb, RGB_LED.sch, SPI.sch]
2020-07-14 Routing der rechten Platinenhälfte
    [MCT_Labor_5529.kicad_pcb]
2020-07-16 Routing komplett
    [MCT_Labor_5529.kicad_pcb]
2020-07-17 Kleine Änderungen
    [MCT_Labor_5529.kicad_pcb]
2020-07-27 Release V1.0
    Kleinigkeiten verändert
    Bestückungsdruck angepasst
    [MCT_Labor_5529.kicad_pcb]
2020-07-28 Anpassungen am Lüfteranschluss und den LEDs
    -Lüfteranschluss verändert
    -> 12V-Versorgung eingefügt
    -LED & LCD auf 3,3V umgestellt
    -> Ladungspunpe für neg. Kontrastspannung
    -keine 5V Versorgung mehr
    [Button_decoder.sch, LCD.sch, LED-Treiber.sch, Launchpad.sch, MCT_Labor_5529.sch, RGB_LED.sch, analog.sch]
2020-07-28 Kleine Änderungen
    Fehler in Kupferflächen und Bestückungsdruck angepasst.
    [MCT_Labor_5529.kicad_pcb]
2020-07-29 Kleine Anpassungen
    [LED-Treiber.sch, Launchpad.sch, MCT_Labor_5529.kicad_pcb]
2020-08-04 LM75 durch TMP411 ersetzt
    -Temperatursensor getauscht
    -3,3V 2mm Buchse hinzugeügt
    -Bohrlöcher wieder eingefügt
    [I2C.sch, MCT_Labor_5529.kicad_pcb, analog.sch]
2020-08-04 LEDs beim TMP411 hinzugegfügt
    [I2C.sch, MCT_Labor_5529.kicad_pcb]
2020-08-05 Erster vorab Release - Fertigungsdaten erstellt
    [Launchpad.sch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]
2021-01-14 minor glitches
    [Launchpad.sch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]
2021-01-14 Kupferfläche auf Top -> GND, 3,3V neu gerouted
    [MCT_Labor_5529.kicad_pcb]
2021-01-21 Aktuell gefertigte Variante
    [Button_decoder.sch, I2C.sch, LCD.sch, Launchpad.sch, MCT_Labor_5529.kicad_pcb, SPI.sch, analog.sch]
2021-01-21 Fertigungsdaten v1.0
    [MCT_Labor_5529-B_Cu.gbl, MCT_Labor_5529-B_Cu.gbr, MCT_Labor_5529-B_Mask.gbr, MCT_Labor_5529-B_Mask.gbs, MCT_Labor_5529-B_Paste.gbp, MCT_Labor_5529-B_Paste.gbr, MCT_Labor_5529-B_SilkS.gbo, MCT_Labor_5529-B_SilkS.gbr]
2021-04-22 Open Hardware Logo eingefügt
    [MCT_Labor_5529.kicad_pcb, RGB_LED.sch]
2021-04-22 Vorbereitet für Release für Group-Buy
    [MCT_Labor_5529-B_Cu.gbl, MCT_Labor_5529-B_Mask.gbs, MCT_Labor_5529-B_Paste.gbp, MCT_Labor_5529-B_SilkS.gbo, MCT_Labor_5529-Edge_Cuts.gm1, MCT_Labor_5529-F_Cu.gtl, MCT_Labor_5529-F_Mask.gts, MCT_Labor_5529-F_Paste.gtp]
2021-04-26 Switched ESP8266F to MICRO32
    [MCT_Labor_5529.kicad_pcb, UART.sch]
2021-04-28 Alternative Footprints für Taster und LCD eingefügt
    [Button_decoder.sch, LCD.sch, MCT_Labor_5529.kicad_pcb]
